dannyjim-ml/idb60-ReplacementPCB/aftermarket_idb60/random-keyboard-parts.pretty-master/PJ-3200B.step

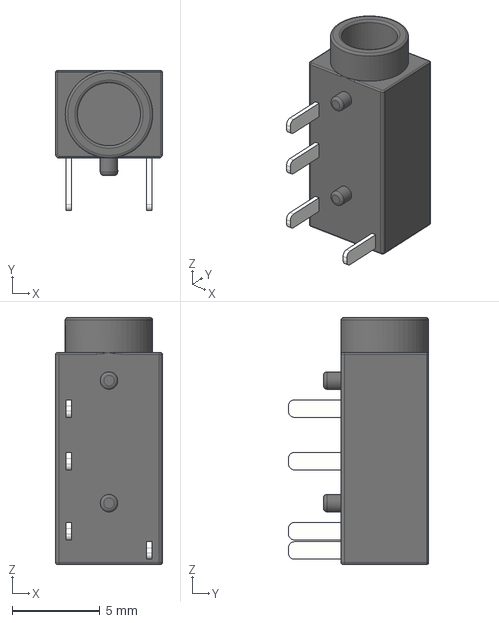
[picture p6: CAD file, 2022-05-28]
aftermarket_idb60/random-keyboard-parts.pretty-master/PJ-3200B.step
6.10 x 8.00 x 14.1 mm
