dannyjim-ml/idb60-ReplacementPCB/aftermarket_idb60/random-keyboard-parts.pretty-master/JST-SR-3.step

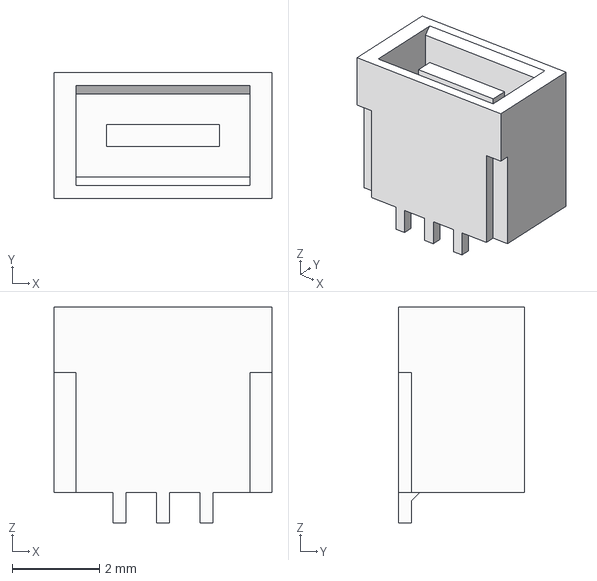
[picture p7: CAD file, 2022-05-28]
aftermarket_idb60/random-keyboard-parts.pretty-master/JST-SR-3.step
5.00 x 2.90 x 4.95 mm
