dannyjim-ml/idb60-ReplacementPCB/aftermarket_idb60/random-keyboard-parts.pretty-master/Molex-0548190519.step

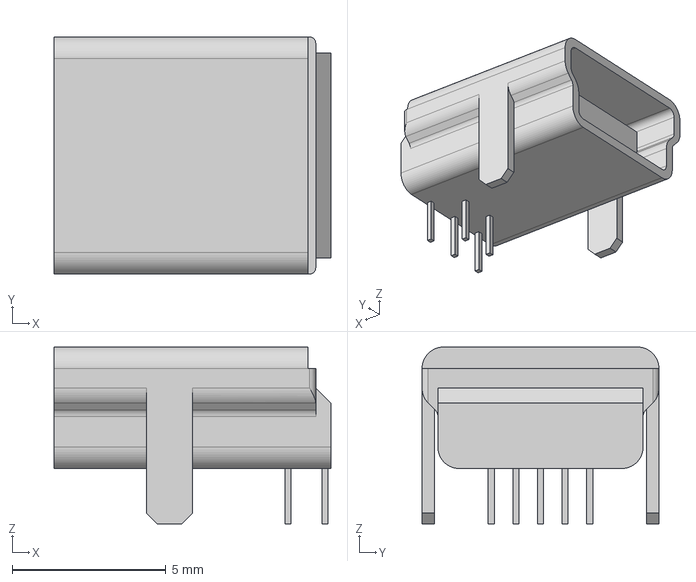
[picture p8: CAD file, 2022-05-28]
aftermarket_idb60/random-keyboard-parts.pretty-master/Molex-0548190519.step
9.00 x 7.70 x 5.75 mm
