dannyjim-ml/idb60-ReplacementPCB/aftermarket_idb60/random-keyboard-parts.pretty-master/JST-SR-4.step

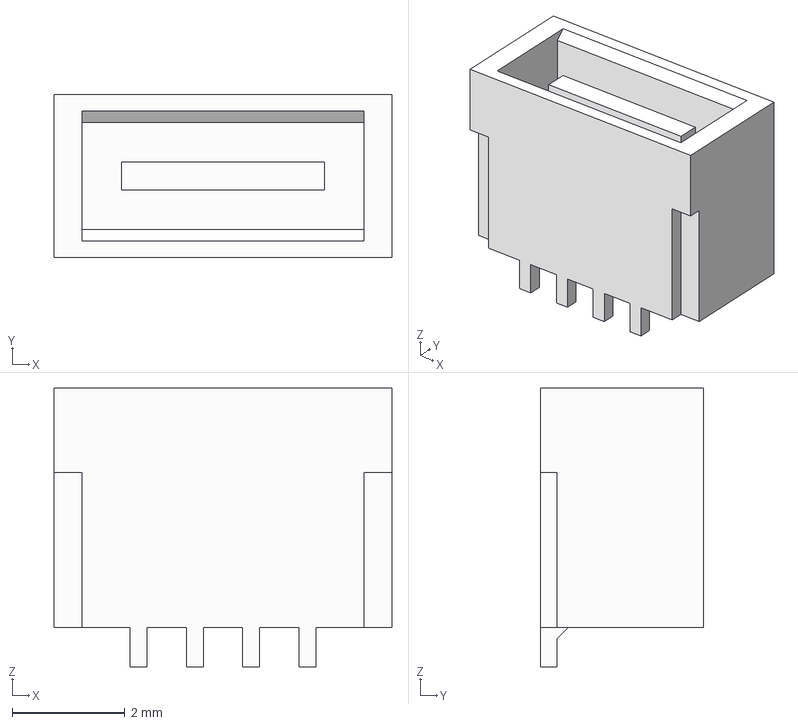
[picture p9: CAD file, 2022-05-28]
aftermarket_idb60/random-keyboard-parts.pretty-master/JST-SR-4.step
6.00 x 2.90 x 4.95 mm
