dannyjim-ml/idb60-ReplacementPCB/(list of files, drawings)

Other design files:
aftermarket_idb60/keyboard.dsn
