dannyjim-ml/idb60-ReplacementPCB/aftermarket_idb60/Matrix.kicad_sch

## KiCad design aftermarket_idb60/Matrix.kicad_sch (2022-05-28)

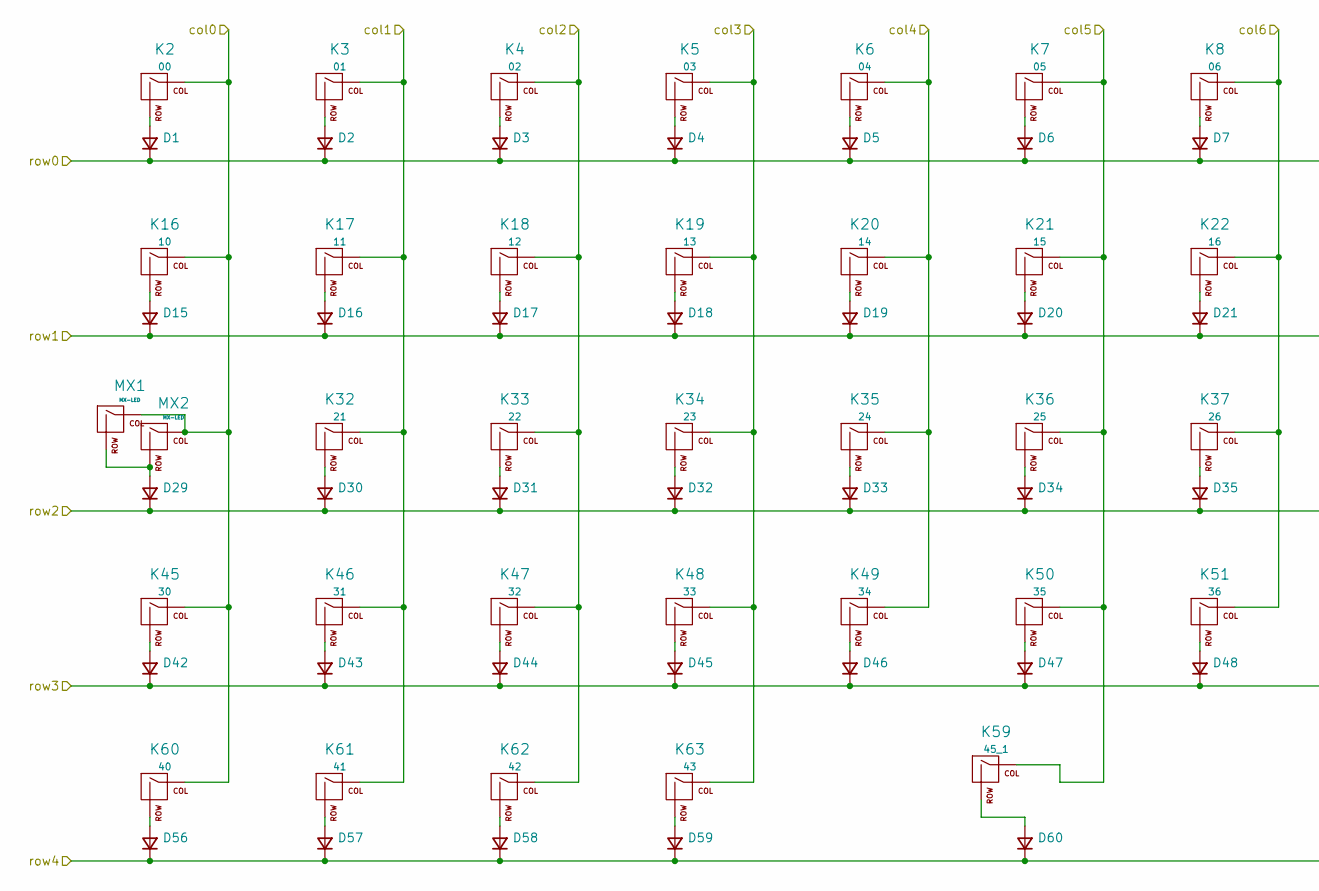
[picture p10: schematic Matrix.kicad_sch, part in row 1, column 1]

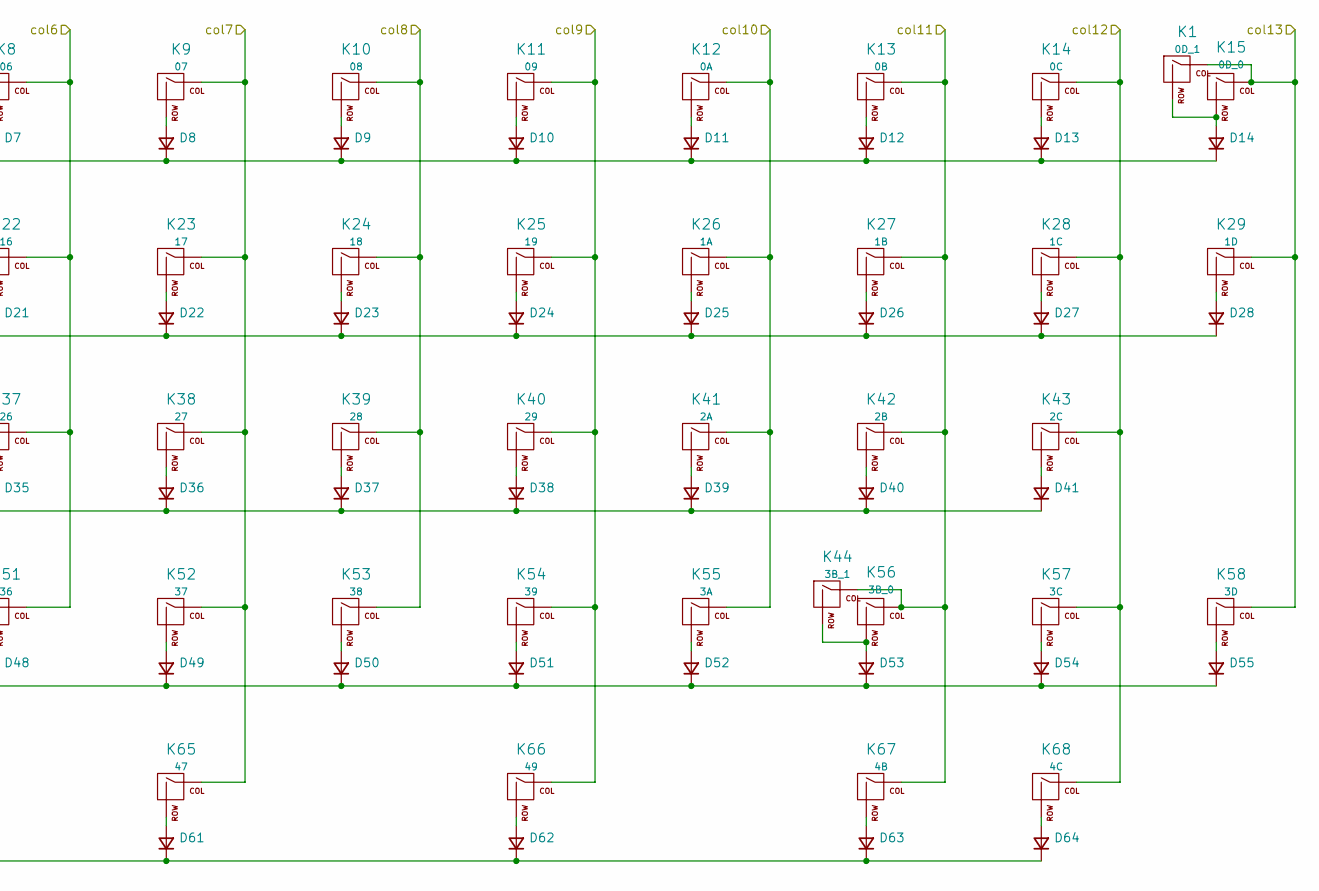
[picture p11: schematic Matrix.kicad_sch, part in row 1, column 2]

Parts:
D1, D2, D3, D4, D5, D6, D7, D8, D9, D10, D11, D12, D13, D14, D15, D16, D17, D18, D19, D20, D21, D22, D23, D24, D25, D26, D27, D28, D29, D30, D31, D32, D33, D34, D35, D36, D37, D38, D39, D40, D41, D42, D43, D44, D45, D46, D47, D48, D49, D50, D51, D52, D53, D54, D55, D56, D57, D58, D59, D60, D61, D62, D63, D64: D_SOD-123
K1: MX_2u_NoLED
K2, K3, K4, K5, K6, K7, K8, K9, K10, K11, K12, K13, K14, K15, K17, K18, K19, K20, K21, K22, K23, K24, K25, K26, K27, K28, K32, K33, K34, K35, K36, K37, K38, K39, K40, K41, K42, K46, K47, K48, K49, K50, K51, K52, K53, K54, K55, K57, K58, K59, K61, K67: MX_1u_NoLED
K16, K29, K60, K62, K66, K68: MX_1.5u_NoLED
K43: MX_2.25u_ReversedStabilizers_NoLED
K44: MX_1.75u_NoLED
K45: MX_2.25u_NoLED
K56: MX_2.75u_NoLED
K63, K65: MX_3u_ReversedStabilizers_NoLED
MX1: MX-LED; MX_1.25u_NoLED
MX2: MX-LED; MX_1.75u_NoLED

Connections:
unnamed: D1.2 (A), K2.2 (ROW)
unnamed: D2.2 (A), K3.2 (ROW)
unnamed: D3.2 (A), K4.2 (ROW)
unnamed: D4.2 (A), K5.2 (ROW)
unnamed: D5.2 (A), K6.2 (ROW)
unnamed: D6.2 (A), K7.2 (ROW)
unnamed: D7.2 (A), K8.2 (ROW)
unnamed: D8.2 (A), K9.2 (ROW)
unnamed: D9.2 (A), K10.2 (ROW)
unnamed: D10.2 (A), K11.2 (ROW)
unnamed: D11.2 (A), K12.2 (ROW)
unnamed: D12.2 (A), K13.2 (ROW)
unnamed: D13.2 (A), K14.2 (ROW)
unnamed: D14.2 (A), K1.2 (ROW), K15.2 (ROW)
unnamed: D15.2 (A), K16.2 (ROW)
unnamed: D16.2 (A), K17.2 (ROW)
unnamed: D17.2 (A), K18.2 (ROW)
unnamed: D18.2 (A), K19.2 (ROW)
unnamed: D19.2 (A), K20.2 (ROW)
unnamed: D20.2 (A), K21.2 (ROW)
unnamed: D21.2 (A), K22.2 (ROW)
unnamed: D22.2 (A), K23.2 (ROW)
unnamed: D23.2 (A), K24.2 (ROW)
unnamed: D24.2 (A), K25.2 (ROW)
unnamed: D25.2 (A), K26.2 (ROW)
unnamed: D26.2 (A), K27.2 (ROW)
unnamed: D27.2 (A), K28.2 (ROW)
unnamed: D28.2 (A), K29.2 (ROW)
unnamed: D29.2 (A), MX1.2 (ROW), MX2.2 (ROW)
unnamed: D30.2 (A), K32.2 (ROW)
unnamed: D31.2 (A), K33.2 (ROW)
unnamed: D32.2 (A), K34.2 (ROW)
unnamed: D33.2 (A), K35.2 (ROW)
unnamed: D34.2 (A), K36.2 (ROW)
unnamed: D35.2 (A), K37.2 (ROW)
unnamed: D36.2 (A), K38.2 (ROW)
unnamed: D37.2 (A), K39.2 (ROW)
unnamed: D38.2 (A), K40.2 (ROW)
unnamed: D39.2 (A), K41.2 (ROW)
unnamed: D40.2 (A), K42.2 (ROW)
unnamed: D41.2 (A), K43.2 (ROW)
unnamed: D42.2 (A), K45.2 (ROW)
unnamed: D43.2 (A), K46.2 (ROW)
unnamed: D44.2 (A), K47.2 (ROW)
unnamed: D45.2 (A), K48.2 (ROW)
unnamed: D46.2 (A), K49.2 (ROW)
unnamed: D47.2 (A), K50.2 (ROW)
unnamed: D48.2 (A), K51.2 (ROW)
unnamed: D49.2 (A), K52.2 (ROW)
unnamed: D50.2 (A), K53.2 (ROW)
unnamed: D51.2 (A), K54.2 (ROW)
unnamed: D52.2 (A), K55.2 (ROW)
unnamed: D53.2 (A), K44.2 (ROW), K56.2 (ROW)
unnamed: D54.2 (A), K57.2 (ROW)
unnamed: D55.2 (A), K58.2 (ROW)
unnamed: D56.2 (A), K60.2 (ROW)
unnamed: D57.2 (A), K61.2 (ROW)
unnamed: D58.2 (A), K62.2 (ROW)
unnamed: D59.2 (A), K63.2 (ROW)
unnamed: D60.2 (A), K59.2 (ROW)
unnamed: D61.2 (A), K65.2 (ROW)
unnamed: D62.2 (A), K66.2 (ROW)
unnamed: D63.2 (A), K67.2 (ROW)
unnamed: D64.2 (A), K68.2 (ROW)
col0: K2.1 (COL), K16.1 (COL), K45.1 (COL), K60.1 (COL), MX1.1 (COL), MX2.1 (COL)
col1: K3.1 (COL), K17.1 (COL), K32.1 (COL), K46.1 (COL), K61.1 (COL)
col2: K4.1 (COL), K18.1 (COL), K33.1 (COL), K47.1 (COL), K62.1 (COL)
col3: K5.1 (COL), K19.1 (COL), K34.1 (COL), K48.1 (COL), K63.1 (COL)
col4: K6.1 (COL), K20.1 (COL), K35.1 (COL), K49.1 (COL)
col5: K7.1 (COL), K21.1 (COL), K36.1 (COL), K50.1 (COL), K59.1 (COL)
col6: K8.1 (COL), K22.1 (COL), K37.1 (COL), K51.1 (COL)
col7: K9.1 (COL), K23.1 (COL), K38.1 (COL), K52.1 (COL), K65.1 (COL)
col8: K10.1 (COL), K24.1 (COL), K39.1 (COL), K53.1 (COL)
col9: K11.1 (COL), K25.1 (COL), K40.1 (COL), K54.1 (COL), K66.1 (COL)
col10: K12.1 (COL), K26.1 (COL), K41.1 (COL), K55.1 (COL)
col11: K13.1 (COL), K27.1 (COL), K42.1 (COL), K44.1 (COL), K56.1 (COL), K67.1 (COL)
col12: K14.1 (COL), K28.1 (COL), K43.1 (COL), K57.1 (COL), K68.1 (COL)
col13: K1.1 (COL), K15.1 (COL), K29.1 (COL), K58.1 (COL)
row0: D1.1 (K), D2.1 (K), D3.1 (K), D4.1 (K), D5.1 (K), D6.1 (K), D7.1 (K), D8.1 (K), D9.1 (K), D10.1 (K), D11.1 (K), D12.1 (K), D13.1 (K), D14.1 (K)
row1: D15.1 (K), D16.1 (K), D17.1 (K), D18.1 (K), D19.1 (K), D20.1 (K), D21.1 (K), D22.1 (K), D23.1 (K), D24.1 (K), D25.1 (K), D26.1 (K), D27.1 (K), D28.1 (K)
row2: D29.1 (K), D30.1 (K), D31.1 (K), D32.1 (K), D33.1 (K), D34.1 (K), D35.1 (K), D36.1 (K), D37.1 (K), D38.1 (K), D39.1 (K), D40.1 (K), D41.1 (K)
row3: D42.1 (K), D43.1 (K), D44.1 (K), D45.1 (K), D46.1 (K), D47.1 (K), D48.1 (K), D49.1 (K), D50.1 (K), D51.1 (K), D52.1 (K), D53.1 (K), D54.1 (K), D55.1 (K)
row4: D56.1 (K), D57.1 (K), D58.1 (K), D59.1 (K), D60.1 (K), D61.1 (K), D62.1 (K), D63.1 (K), D64.1 (K)
