dannyjim-ml/idb60-ReplacementPCB/aftermarket_idb60/keyboard.kicad_sch

## KiCad design aftermarket_idb60/keyboard.kicad_sch (2022-05-28)

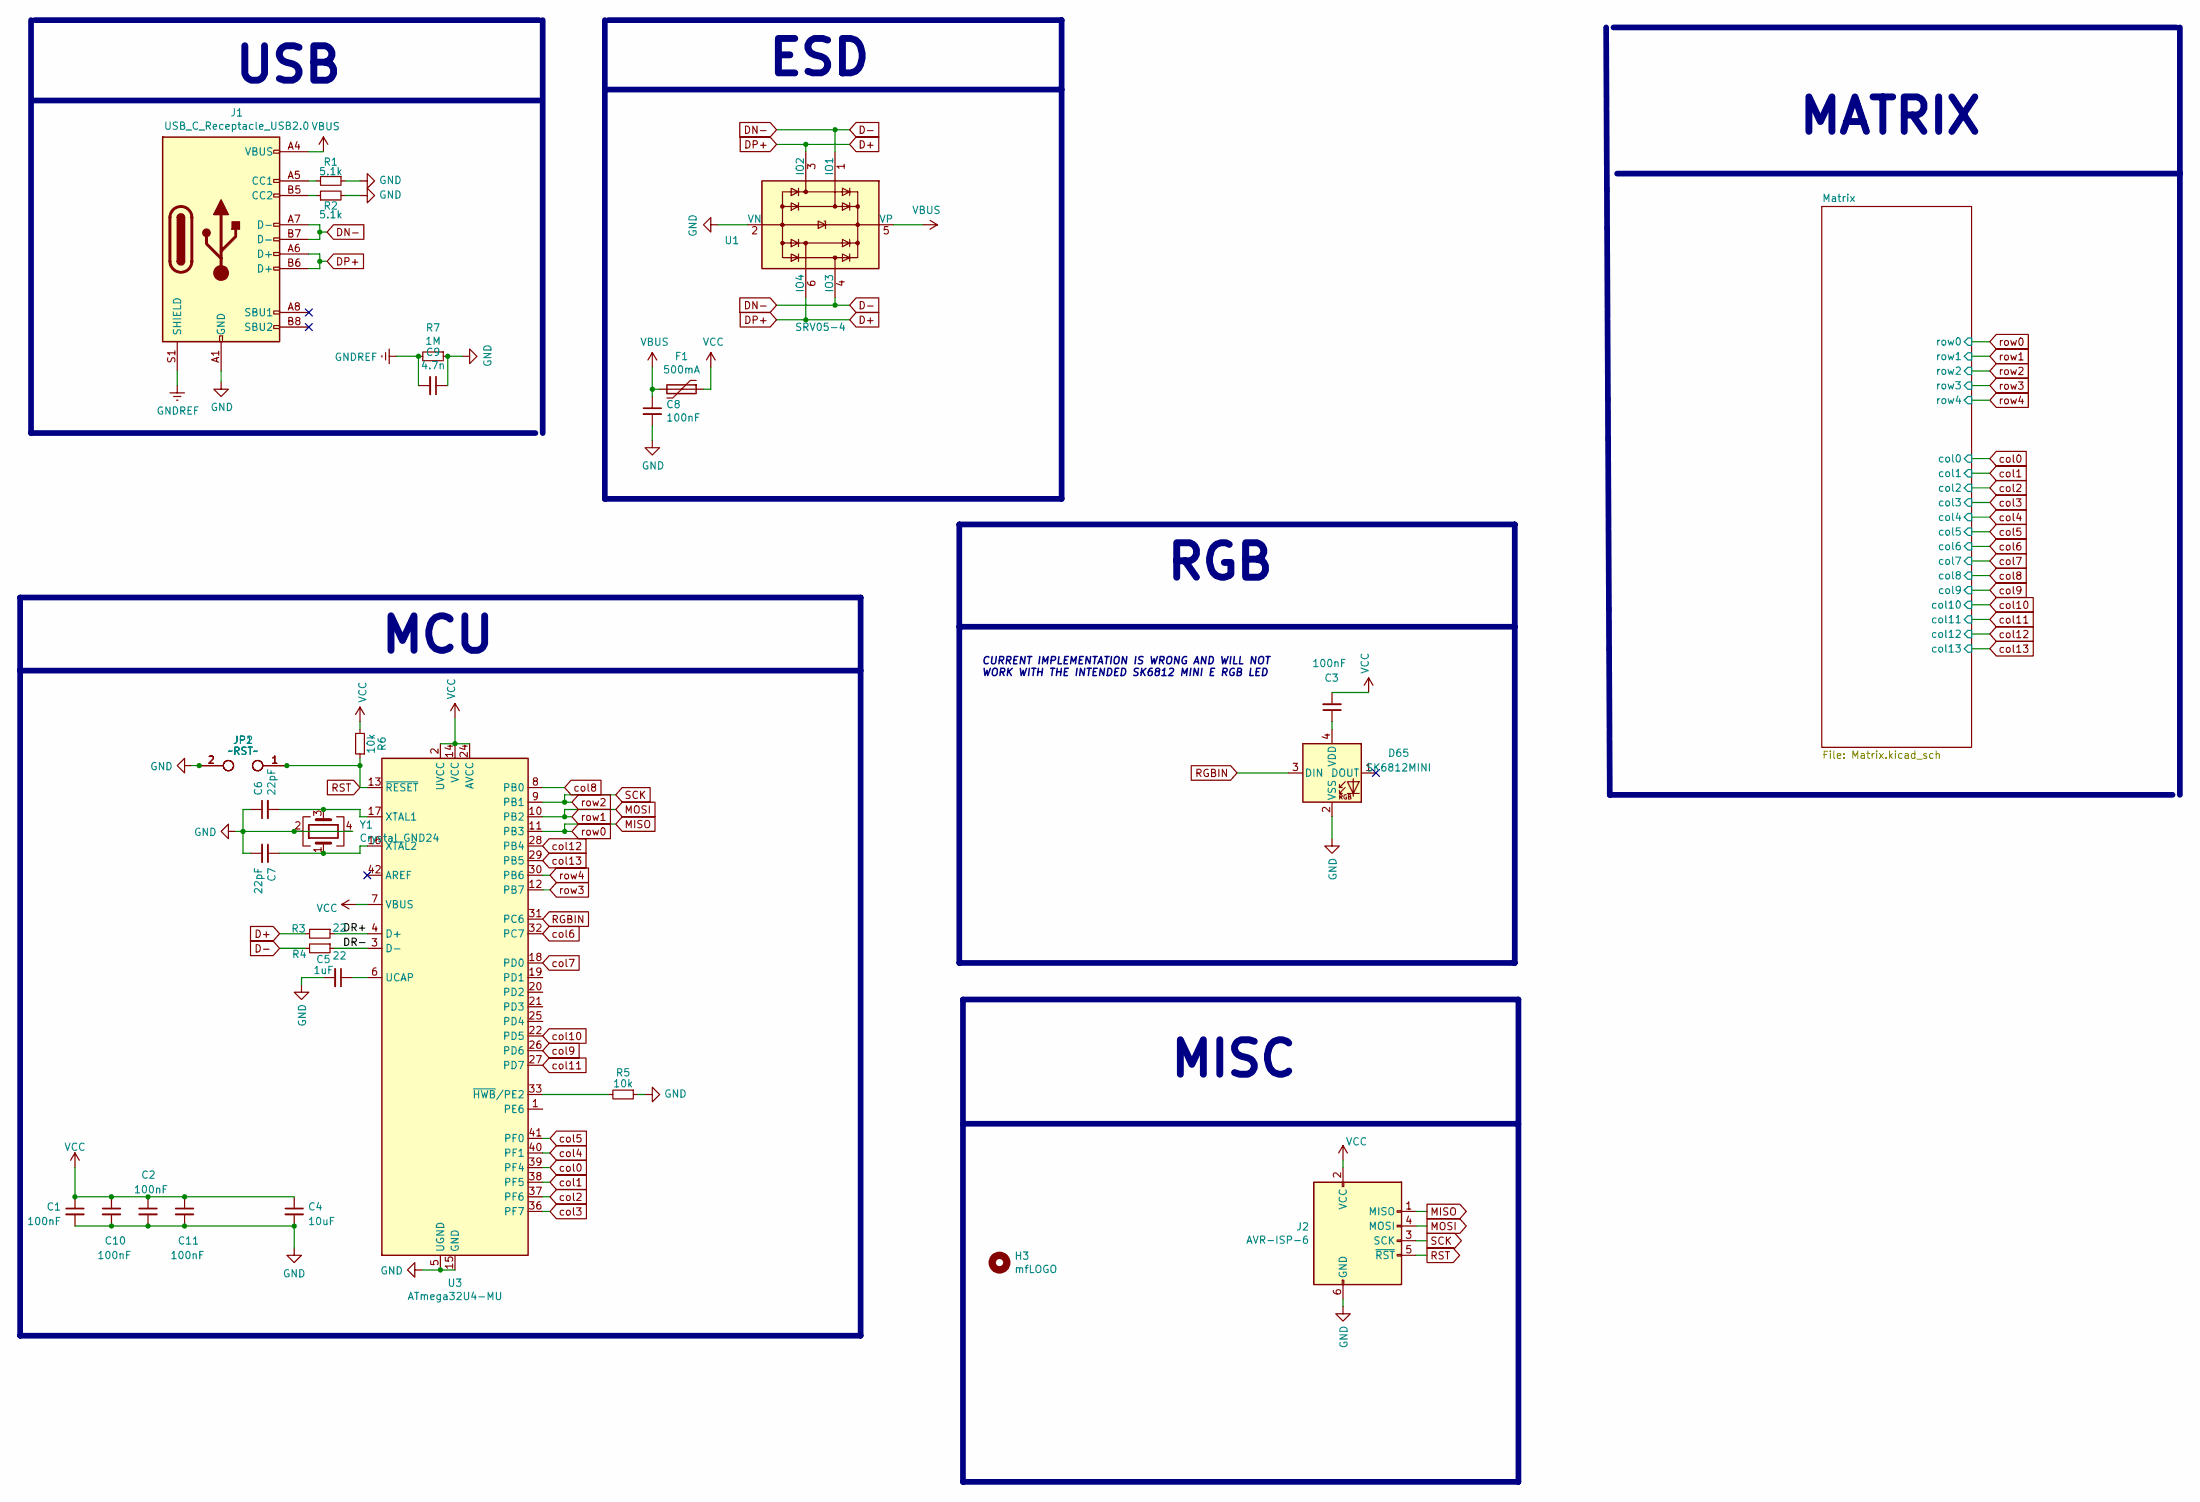
[picture p12: schematic keyboard.kicad_sch]

Parts:
C1, C2, C3, C8, C10, C11: 100nF; C_0603_1608Metric; LCSC C129175
C4: 10uF; C_0603_1608Metric; LCSC C32635
C5: 1uF; C_0603_1608Metric
C6, C7: 22pF; C_0603_1608Metric
C9: 4.7n; C_0805_2012Metric
D65: SK6812MINI; SK6812-MINI-E
F1: 500mA; Fuse_1206_3216Metric
H3: mfLOGO; MFLogoPCB
J1: USB_C_Receptacle_USB2.0; USB_C_Receptacle_HRO_TYPE-C-31-M-12; LCSC C165948
J2: AVR-ISP-6; AVR_ICSP_3x2
JP1, JP2: ~RST~; SolderJumper-2_P1.3mm_Open_RoundedPad1.0x1.5mm
R1, R2: 5.1k; R_0805_2012Metric; LCSC C27834
R3, R4: 22; R_0603_1608Metric; LCSC C17561
R5: 10k; R_0603_1608Metric; LCSC C17414
R6: 10k; R_0805_2012Metric; LCSC C17414
R7: 1M; R_0805_2012Metric
U1: SRV05-4; SOT-23-6
U3: ATmega32U4-MU; QFN-44-1EP_7x7mm_P0.5mm_EP5.2x5.2mm
Y1: Crystal_GND24; Crystal_SMD_3225-4Pin_3.2x2.5mm

Connections:
D+: J1.A6 (D+), J1.B6 (D+), R3.2, U1.3 (IO2), U1.6 (IO4)
D-: J1.A7 (D-), J1.B7 (D-), R4.2, U1.1 (IO1), U1.4 (IO3)
DR+: R3.1, U3.4 (D+)
DR-: R4.1, U3.3 (D-)
GND: C1.2, C2.2, C4.2, C5.2, C6.1, C7.2, C8.2, C9.1, C10.2, C11.2, D65.2 (VSS), J1.A1 (GND), J1.A12 (GND), J1.B1 (GND), J1.B12 (GND), J2.6 (GND), JP1.2, JP2.2, R1.1, R2.2, R5.1, R7.1, U1.2 (VN), U3.5 (UGND), U3.15 (GND), U3.23 (GND), U3.35 (GND), U3.43 (GND), U3.45 (GND), Y1.2, Y1.4
GNDREF: C9.2, J1.S1 (SHIELD), R7.2
MISO: J2.1 (MISO), U3.11 (PB3)
MOSI: J2.4 (MOSI), U3.10 (PB2)
unnamed: C3.1, D65.4 (VDD)
unnamed: C5.1, U3.6 (UCAP)
unnamed: C6.2, U3.17 (XTAL1), Y1.3
unnamed: C7.1, U3.16 (XTAL2), Y1.1
unnamed: J1.A5 (CC1), R1.2
unnamed: J1.B5 (CC2), R2.1
unnamed: R5.2, U3.33 (~HWB/PE2)
RGBIN: D65.3 (DIN), U3.31 (PC6)
RST: J2.5 (~RST), JP1.1, JP2.1, R6.1, U3.13 (~RESET)
VBUS: C8.1, F1.2, J1.A4 (VBUS), J1.A9 (VBUS), J1.B4 (VBUS), J1.B9 (VBUS), U1.5 (VP)
VCC: C1.1, C2.1, C3.2, C4.1, C10.1, C11.1, F1.1, J2.2 (VCC), R6.2, U3.2 (UVCC), U3.7 (VBUS), U3.14 (VCC), U3.24 (AVCC), U3.34 (VCC), U3.44 (AVCC)
col0: U3.39 (PF4)
col1: U3.38 (PF5)
col2: U3.37 (PF6)
col3: U3.36 (PF7)
col4: U3.40 (PF1)
col5: U3.41 (PF0)
col6: U3.32 (PC7)
col7: U3.18 (PD0)
col8: U3.8 (PB0)
col9: U3.26 (PD6)
col10: U3.22 (PD5)
col11: U3.27 (PD7)
col12: U3.28 (PB4)
col13: U3.29 (PB5)
row2: J2.3 (SCK), U3.9 (PB1)
row3: U3.12 (PB7)
row4: U3.30 (PB6)

Notes on the sheet:
USB
MATRIX
MCU
MISC
RGB
ESD
CURRENT IMPLEMENTATION IS WRONG AND WILL NOT WORK WITH THE INTENDED SK6812 MINI E RGB LED
